tattooboat/Mini_VCU/F407_Main/2阶段Day4_LVGL本地电机控制与仪表盘整合总结.md

# Day 4：LVGL 本地电机控制与仪表盘整合总结

> 项目：STM32F407VGT6 简化车载 ECU 控制系统\
> 阶段：4-4-2 ～ 4-7\
> 状态：已完成（按本阶段已确认的验收结果整理）

## 一、阶段目标

在 LCD/LVGL
显示、触摸输入和页面切换的基础上，完成本地电机控制、运行状态显示、仪表盘布局优化、故障保护和系统整合测试。

控制链路：

**触摸操作 → 本地控制请求 → FreeRTOS 电机控制任务 → PID/驱动输出 →
电机**

LVGL 回调负责更新控制请求，不直接操作
PWM；电机输出由统一的控制任务管理。

## 二、完成内容与验收结果

  --------------------------------------------------------------------------------------------------------------
  阶段                    任务                                    验收结果
  ----------------------- --------------------------------------- ----------------------------------------------
  4-4-2                   本地启动、停止、速度设置                控制页触摸操作可修改本地控制状态和目标值

  4-4-2                   触摸按钮控制 PID 目标值                 触摸输入更新 PID
                                                                  使用的目标值，由控制任务执行电机控制

  4-4-3                   真实状态显示                            页面显示本地控制状态及运行数据

  4-4-3                   显示目标值、PWM、运行状态、反馈有效性   目标值、PWM、运行状态和反馈有效性纳入显示

  4-5                     仪表盘 UI 美化                          主页和控制页主要信息布局完成调整

  4-5                     主页和控制页布局完善                    页面切换和主要控件显示完成

  4-6                     故障保护与安全状态机                    控制流程纳入故障状态管理

  4-6                     急停、超时、异常停机、重新启动          对应保护与恢复流程完成验收

  4-7                     系统整合测试                            显示、触摸、本地控制、任务和驱动模块完成整合

  4-7                     长时间运行、切换页面、反复启停          已完成相应稳定性测试
  --------------------------------------------------------------------------------------------------------------

## 三、系统结构

``` text
触摸屏 / LVGL 控制页
        |
        | START / STOP / 目标值设置
        v
本地电机控制应用层
        |
        | 控制目标与使能状态
        v
FreeRTOS 电机控制任务
        |
        | PID 运算 / 安全检查
        v
PWM 电机驱动
        |
        v
直流电机
```

  模块                 主要职责
  -------------------- --------------------------------------------------
  LCD/LVGL UI          页面显示、触摸交互、运行状态展示
  本地电机控制应用层   管理启动/停止请求和目标值
  FreeRTOS 控制任务    周期性读取控制请求并执行控制逻辑
  PID 模块             根据目标值进行控制计算
  电机驱动模块         输出 PWM，控制电机运行
  故障管理             检查异常状态，触发安全停机和恢复流程
  CAN 通信模块         保留双节点通信能力，不作为本地触摸控制的必经链路

## 四、关键设计说明

### 1. 本地直控

采用 F407 本地直控。触摸屏直接更新本地控制请求，由 F407
控制任务执行，不再依赖 CAN 报文才能控制本机电机。应避免 CAN
控制与本地触摸控制同时争夺电机控制权。

### 2. PWM 控制入口统一

LVGL 回调不直接调用底层 PWM
输出函数。启动、停止和目标值修改通过应用层接口传递给控制任务，PWM
输出由控制任务统一管理。

### 3. 编码器反馈与真实转速显示

本机采用**带编码器的直流减速电机**，编码器接 TIM8（配置为编码器模式）：
- 由 `Int_Encoder_GetOutputRPM` 按脉冲数、解倍数和减速比换算得到**真实实测转速**。
- 主页 `MOTOR SPEED` 显示的是编码器实测实际转速，`TGT` 显示目标转速，两者分开展示，实现速度闭环的基础。
- 控制任务读取编码器并发布 `g_ui_actual_rpm`，供 UI 显示；修改变量化前应核对减速比与脉冲数参数，保证换算准确。

## 五、Day 4 完成验收清单

-   [x] 控制页本地启动和停止
-   [x] 触摸修改本地目标值
-   [x] 控制任务统一执行电机控制
-   [x] 页面显示目标值、PWM 和运行状态
-   [x] 反馈有效性有明确标识
-   [x] 主页与控制页布局完善
-   [x] 故障保护与安全状态管理完成
-   [x] 急停、超时、异常停机及重新启动流程完成
-   [x] 系统整合测试完成
-   [x] 长时间运行、页面切换和反复启停测试完成

## 六、Day 5 及后续安排

### 5-1：工程整理与代码质量

1.  检查 UI、应用层、控制任务、PID 和 BSP 驱动的模块边界。
2.  检查共享变量并发访问，必要时使用队列、互斥锁或临界区。
3.  检查任务周期、优先级、堆栈和运行时间。
4.  统一命名、注释、错误码和日志输出。
5.  清理未使用的旧 CAN 电机控制代码，避免存在两套控制入口。

**验收：** 工程可从干净环境重新编译，模块依赖清晰，无重复控制入口。

### 5-2：传感器与真实反馈能力

1.  已采用带编码器的直流减速电机，接入 TIM8 并完成脉冲计数与速度换算。
2.  核对编码器每转脉冲数、解倍数与齿轮减速比，保证 RPM 换算准确。
3.  完善速度滤波与反馈有效性（编码器是否在线/损坏）判断。
4.  对比目标值与编码器实测值，验证闭环 PID 调速效果。

**验收：** 显示数据来源明确；主页实际转速为编码器实测值，可与目标值对比验证闭环。

### 5-3：故障注入与保护验证

1.  测试 CAN 断连、传感器数据异常和控制请求超时等场景。
2.  测试运行中急停，以及复位后的重新启动。
3.  检查故障发生时 PWM 是否进入安全值。
4.  检查故障未解除时是否禁止重新启动。
5.  记录故障码、触发条件和恢复步骤。

**验收：** 每种故障都有可复现的触发方式、明确的安全动作和恢复条件。

### 5-4：项目展示与交付

1.  整理系统框图、软件架构图和 CAN 协议说明。
2.  整理 CubeMX 配置、引脚连接表和硬件清单。
3.  录制主页、控制页、启停控制和故障保护演示视频。
4.  编写
    README：项目功能、硬件连接、软件环境、编译步骤、测试结果和已知限制。
5.  整理关键代码截图和测试记录，形成简历项目材料。

**验收：** 其他人按照 README 能理解项目结构、完成编译并复现核心功能。

## 七、建议优先级

  优先级   后续任务                           原因
  -------- ---------------------------------- ------------------------------
  P0       工程整理、干净编译、共享变量检查   保证项目可维护、可复现
  P1       故障注入测试和测试记录             证明保护逻辑有效
  P1       编码器换算校准与反馈有效性判断     保证主页实际转速显示准确
  P2       编码器速度闭环 PID 验证            利用编码器实测转速做闭环调速
  P2       README、架构图、演示视频           用于毕业设计和嵌入式实习面试

## 八、阶段总结

Day 4
完成了从"屏幕显示和触摸操作"到"触摸屏参与本地电机控制，并具备状态展示和安全管理"的整合。

下一步不建议盲目增加功能。先完成工程整理、故障注入验证和项目文档，再校准编码器速度闭环并完善真实转速显示，让项目从可运行的练习工程提升为结构清晰、可验证、可展示的嵌入式项目。

## 九、追加：界面优化与急停整合改动记录

本次在 Day 4 基础上对 UI 与安全逻辑做了如下调整，并修复了实测中发现的问题。

### 9.1 新添加 / 修改内容

| 项目 | 说明 |
| ---- | ---- |
| 控制页按钮重排 | 由拥挤多行小按钮改为**三行两列大按钮**（实际转速/启停/调速/急停复位），按钮高度提升到 34px，消除重叠、触摸命中区更大 |
| 全页面禁用滚动 | 主页、控制页及其所有卡片统一 `LV_SCROLLBAR_MODE_OFF`，页面固定不滑动，避免触摸屏误滑或触发翻页 |
| 急停(E-STOP)最高优先级锁存 | 新增 `App_MotorControl_EMStop/IsEMLatched/ReleaseEMStop`，E-STOP 后立即停机并 **锁存**，忽略一切外部/本地目标，直到显式 RESET；新增 `FAULT_EMERGENCY_STOP` 与 `MOTOR_FAULT_ESTOP` 故障/反馈码 |
| RESET 与回归 CAN 合并 | 原「RESET」与「CAN MODE」合成一个 `RESET`：急停锁存时复位急停，否则释放停机锁存交还 CAN，减少一个按键、步骤更少 |
| 主页显示真实数据 | 移除演示值 `120 km/h / DEMO VALUE`，改为主页显示真实实际转速(`MOTOR SPEED`)、目标转速(`TGT`)、PWM 占空比、运行状态(`RUNNING/STOPPED/E-STOP`)与反馈 `TX` |
| 状态联动真实化 | 电机运行状态、PWM、目标值均取自控制任务发布的 `g_ui_actual_rpm/g_ui_target_rpm/g_ui_pwm`，本地/CAN 两种模式都显示真实数据，并明确区分"实际转速"与"目标转速" |
| 浮点显示格式修复 | 主页速度由 `%.0f`（精度浮点）改为 `%d` 取整显示，规避设备端内置 printf 对浮点精度渲染乱码的问题 |

### 9.2 实测中遇到的问题与解决（用户反馈汇总）

| 问题 | 现象 | 处理 |
| ---- | ---- | ---- |
| 控制页按钮重叠 | 原布局按钮尺寸偏小、第二行与第一行底部重合，视觉拥挤、难按准 | 重排为三行两列大按钮，行间隔 4px，等宽对齐，无重叠 |
| 触摸不灵敏、易滑动 | 触摸命中区小、页面疑似可滑动 | 放大按钮（34px 高、140px 宽），并对整页与所有卡片禁用滚动 |
| 主页速度不是真实数据 | 仍显示 `120 km/h / DEMO VALUE` 等演示值，标题 `VEHICLE SPEED` 语义误导 | 改为 `MOTOR SPEED` + 真实实际转速、`TGT` 目标转速、`PWM` 与真实运行状态，删除全部演示文案 |
| 主页速度框显示乱码（`frmp`） | `%.0f` 精度浮点在设备内置 printf 下未能正常输出数字，界面出现异常字符 | 将实际/目标转速改为 `%d` 整数取整显示，乱码消失、显示干净整数 |
| 操作步骤偏多 | 启停、调速、急停、回归 CAN 分散在多个小按钮，逻辑零散 | 归并 `RESET`/`CAN MODE`，按"启停 → 调速 → 急停/复位"三行分组，步骤更直观 |

### 9.3 相关说明（编码器反馈）

本机为**带编码器的直流减速电机**。主页速度框由控制任务发布的 `g_ui_actual_rpm`（`Int_Encoder_GetOutputRPM` 读取 TIM8 编码器换算）驱动，显示的是**编码器实测真实转速**；`TGT` 显示目标转速。后续只需核对编码器脉冲数/解倍数/减速比参数，即可保证换算准确、用于闭环 PID 验证。
