tattooboat/Mini_VCU/F407_Main/Core/Src/main.c

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
/* Includes ------------------------------------------------------------------*/
#include "main.h"
#include "cmsis_os.h"
#include "adc.h"
#include "can.h"
#include "i2c.h"
#include "tim.h"
#include "usart.h"
#include "gpio.h"

/* USER CODE BEGIN Includes */
#include "Int_aht20.h"
#include <stdio.h>
#include <string.h>
#include "Int_can.h"
#include "Int_motor.h"
#include "lcd_ili9341.h"
#include "Int_XPT2046.h"
#include "lvgl.h"
#include "lv_port_disp.h"
/* USER CODE END Includes */


/* USER CODE BEGIN PV */
uint8_t can_test_data[8] =
{
    0x01,  /* ???PING */
    0x01,  /* ????1 */
    0x01,  /* ??????1 */
    0x00,  /* ?????? */
    0x00,  /* ?????? */
    0x00,  /* ???? */
    0x00,  /* ?? */
    0x03   /* ????01+01+01=03 */
};

volatile HAL_StatusTypeDef can_tx_status = HAL_ERROR;
volatile uint32_t can_tx_count = 0;

volatile uint32_t f407_rx_count = 0;
volatile uint32_t f407_last_id = 0;
volatile uint8_t  f407_last_dlc = 0;
volatile uint8_t  f407_last_data[8] = {0};


/* USER CODE END PV */

void SystemClock_Config(void);
void MX_FREERTOS_Init(void);
/**
  * @brief  The application entry point.
  * @retval int
  */
int main(void)
{

  /* MCU Configuration--------------------------------------------------------*/

  /* Reset of all peripherals, Initializes the Flash interface and the Systick. */
  HAL_Init();

  /* Configure the system clock */
  SystemClock_Config();

  /* Initialize all configured peripherals */
  MX_GPIO_Init();
  MX_USART1_UART_Init();
  MX_TIM2_Init();
  MX_TIM3_Init();
  MX_ADC1_Init();
  MX_I2C1_Init();
  MX_CAN1_Init();
  MX_TIM8_Init();
  /* USER CODE BEGIN 2 */
  Int_XPT2046_Init();
  LCD_Init();
  /* 初始化 LVGL 内核与显示驱动 */
  lv_init();
  lv_port_disp_init();

  /* 启动 CAN，使能接收（此前诊断阶段临时注释，现已查明卡死与 CAN 无关） */
  if (INT_CAN_Start() != HAL_OK)
  {
      Error_Handler();
  }

  HAL_Delay(100);

  // can_tx_status =
  //     INT_CAN_SendStd(0x123, can_test_data, 8, 100);

  can_tx_count++;
  // AHT20_Status_t aht_status;
  // AHT20_Data_t aht_data;

  // aht_status = AHT20_Init();

  // if (aht_status == AHT20_OK)
  // {
  //     const char *msg = "AHT20 Init OK\r\n";

  //     HAL_UART_Transmit(&huart1,
  //                       (uint8_t *)msg,
  //                       strlen(msg),
  //                       1000);
  // }
  // else
  // {
  //     const char *msg = "AHT20 Init FAILED\r\n";

  //     HAL_UART_Transmit(&huart1,
  //                       (uint8_t *)msg,
  //                       strlen(msg),
  //                       1000);
  // }

  /* USER CODE END 2 */

  /* Init scheduler */
  osKernelInitialize();

  /* Call init function for freertos objects (in cmsis_os2.c) */
  MX_FREERTOS_Init();

  /* Start scheduler */
  osKernelStart();

  /* We should never get here as control is now taken by the scheduler */

  /* Infinite loop */
  /* USER CODE BEGIN WHILE */
  while (1)
  {
    /* USER CODE END WHILE */

    /* USER CODE BEGIN 3 */
    
  }
  /* USER CODE END 3 */
}

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
