tattooboat/Mini_VCU/F407_Main/F407_Main.ioc

Mcu.UserName=STM32F407VGTx
PA0-WKUP.Signal=ADCx_IN0
PA10.Signal=USART1_RX
PA11.Signal=CAN1_RX
PA12.Signal=CAN1_TX
PA13.Signal=SYS_JTMS-SWDIO
PA14.Signal=SYS_JTCK-SWCLK
PA5.GPIO_Label=LED
PA5.Signal=GPIO_Output
PA6.Signal=S_TIM3_CH1
PA9.Signal=USART1_TX
PB0.Signal=S_TIM3_CH3
PB12.Signal=GPIO_Output
PB13.Signal=GPIO_Output
PB14.Signal=GPIO_Output
PB15.Signal=GPIO_Output
PB3.Signal=GPIO_Input
PB4.Signal=GPIO_Output
PB5.Signal=GPIO_Output
PB6.Signal=I2C1_SCL
PB7.Signal=I2C1_SDA
PC0.GPIO_Label=SCK
PC0.Signal=GPIO_Output
PC1.GPIO_Label=SDI(MOSI)
PC1.Signal=GPIO_Output
PC14-OSC32_IN.Signal=RCC_OSC32_IN
PC15-OSC32_OUT.Signal=RCC_OSC32_OUT
PC2.Signal=GPIO_Output
PC3.GPIO_Label=CS
PC3.Signal=GPIO_Output
PC4.GPIO_Label=D/C
PC4.Signal=GPIO_Output
PC5.GPIO_Label=RESET
PC5.Signal=GPIO_Output
PC6.Signal=S_TIM8_CH1
PC7.Signal=S_TIM8_CH2
PC8.Signal=GPIO_Output
PC9.Signal=GPIO_Input
PH0-OSC_IN.Signal=RCC_OSC_IN
PH1-OSC_OUT.Signal=RCC_OSC_OUT
