tattooboat/Mini_VCU/F407_Main/Core/Inc/main.h

#define SCK_Pin GPIO_PIN_0
#define SCK_GPIO_Port GPIOC
#define SDI_Pin GPIO_PIN_1
#define SDI_GPIO_Port GPIOC
#define CS_Pin GPIO_PIN_3
#define CS_GPIO_Port GPIOC
#define LED_Pin GPIO_PIN_5
#define LED_GPIO_Port GPIOA
#define D_C_Pin GPIO_PIN_4
#define D_C_GPIO_Port GPIOC
#define RESET_Pin GPIO_PIN_5
#define RESET_GPIO_Port GPIOC
