tattooboat/Mini_VCU/(commit log)

2026-10-26 2阶段Day1_LCD_FreeRTOS开发记录
2026-10-26 Mini VCU 屏幕开发 Day 2：完善 ILI9341 图形驱动
2026-10-27 Day 3：XPT2046 触摸驱动与原始坐标映射
2026-10-31 2阶段Day4_LVGL本地电机控制与仪表盘整合
